finnyoun9/bluepill-ota-bootloader/CHANGELOG.md

# Changelog / 开发变更记录

> 这不是正式 release tag；项目还处于原型联调阶段。下面的 `v0.x` 是为了方便回顾而补的**开发里程碑编号**，提交 SHA 才是源码的唯一版本依据。
>
> These are development milestones, not formal release tags. The Git commit SHA remains the source of truth for every revision.

## Current status / 当前状态

- An MQTT client on the public EMQX sandbox broker (`broker.emqx.io:1883`) is implemented: it publishes the same sensor JSON as `GET /api/sensors` on a MAC-namespaced topic and accepts the same control fields as `POST /api/control` on a matching subscribe topic. **Code compiles cleanly but is not yet hardware-verified.**
- 公共 EMQX 沙盒 broker（`broker.emqx.io:1883`）的 MQTT 客户端已实现：在按 MAC 地址命名空间隔离的 topic 上发布与 `GET /api/sensors` 相同的传感器 JSON，并在对应订阅 topic 上接受与 `POST /api/control` 相同的控制字段。**代码编译通过，尚未实机验证。**
- Two active-low relay channels on PA2/PA3 and an active-low buzzer on PB1 are hardware-verified. Bluetooth supports `RELAY1/RELAY2 ON|OFF`, `RELAY`, `AUTO ON|OFF`, `MANUAL`, and `BUZZER ON|OFF`.
- PA2/PA3 两路低电平触发继电器与 PB1 低电平触发蜂鸣器均已实机验证；蓝牙命令覆盖 `RELAY1/RELAY2 ON|OFF`、`RELAY`、`AUTO ON|OFF`、`MANUAL` 和 `BUZZER ON|OFF`。
- The 15-LED WS2812B strip is hardware-verified on PB5 using a 64MHz clock-dependent GPIO bit-bang driver. The BH1750 now drives a smoothed inverse brightness curve, and frames are sent only when brightness changes.
- 15 颗 WS2812B 已在 PB5 上通过 64MHz 时钟相关的 GPIO 位操作驱动完成实机验证；BH1750 采用平滑反向亮度曲线，只有亮度变化时才发送新帧。
- The STM32 application now provides a hardware-verified local environment terminal with an SSD1306 menu, EC11 navigation, BH1750 light sensing, HC-SR501 motion sensing, and AHT20/BMP280 temperature-humidity-pressure readings.
- STM32 Application 已形成实机验证的本地环境终端：SSD1306 菜单、EC11 导航、BH1750 光照、HC-SR501 人体感应，以及 AHT20/BMP280 温湿度气压采集均已跑通。
- All four I2C devices share I2C1 on `PB6/PB7 @ 100kHz`; the split OLED/TFT application uses 17,900 B RAM (87.4%) and 33,192 B Flash (50.6%).
- 四个 I2C 设备当前共用 `PB6/PB7 @ 100kHz` 的 I2C1；双屏分工后的 Application 占用 RAM 17,900 B（87.4%）、Flash 33,192 B（50.6%）。
- Phone-driven Web OTA is hardware-verified: an iPhone connected directly to the ESP32 SoftAP, uploaded the STM32 application, and completed the update without a PC-side sender.
- 手机 Web OTA 已通过实机验证：iPhone 直连 ESP32 SoftAP、上传 STM32 Application，并在不使用电脑发包工具的情况下完成升级。
- The Web update moved the target from firmware version 1 to 2; a follow-up Bluetooth `VERSION` query returned `FW Version: 2`.
- Web 升级将目标版本从 1 更新到 2；随后通过蓝牙 `VERSION` 查询得到 `FW Version: 2`。
- The full PC → Bluetooth SPP → ESP32 SPIFFS → STM32 bootloader → Flash/CRC → application path is now hardware-verified.
- PC → 蓝牙 SPP → ESP32 SPIFFS → STM32 Bootloader → Flash/CRC → Application 的完整路径现已通过实机验证。
- A 15,956-byte application image (`CRC32 0x3B274D7E`) completed OTA successfully, and the updated STM32 application replied `FW Version: 1` after reboot.
- 15,956 字节的应用镜像（`CRC32 0x3B274D7E`）已完成 OTA；重启后 STM32 新应用返回 `FW Version: 1`。
- All three firmware targets build, the protocol smoke test passes both the classic and all-byte CRC vectors, and the current hardware wiring is stable at USART1 115200 baud.
- 三端固件均可构建；协议烟测同时覆盖经典 CRC 向量和全字节向量；当前硬件接线在 USART1 115200 baud 下稳定工作。
- The realtime Web dashboard is hardware-verified end to end: an 18-byte STM32 fixed-point snapshot, a 1-second ESP32 UART cache, and `GET /api/sensors`, with both firmware images flashed and live LAN data confirmed.
- 实时 Web 仪表盘已完成端到端实机验证：STM32 18 字节定点快照、ESP32 每秒 UART 缓存和 `GET /api/sensors` 均已烧录运行，局域网页面能持续显示真实数据。

## Milestones / 里程碑

### Unreleased — MQTT cloud publish/control / MQTT 上云发布与控制

- 中文：新增 `mqtt_client`（ESP-IDF `esp-mqtt`，通过 IDF Component Registry 引入），连接公共 EMQX 沙盒 broker `broker.emqx.io:1883`（无需账号，未加密）。Client ID 和 topic（`envlink/<mac后3字节>/sensors`、`.../control`）用 STA MAC 地址后 3 字节命名空间隔离，避免和其他设备撞车。之后若切换到私有 broker（如 EMQX Cloud Serverless 免费版），只需改 `MQTT_BROKER_URI`。
- English: Added an `esp-mqtt` client (pulled in via the ESP-IDF Component Registry) connecting to the public EMQX sandbox broker `broker.emqx.io:1883` (no account, unencrypted). The client ID and topics (`envlink/<mac-suffix>/sensors`, `.../control`) are namespaced by the last 3 bytes of the STA MAC address to avoid colliding with other clients on the shared broker. Moving to a private broker later (e.g. a free EMQX Cloud Serverless deployment) only requires changing `MQTT_BROKER_URI`.
- 中文：重构提取出 `format_sensor_json()` 和 `build_control_message()`/`send_control_message()`，HTTP 的 `/api/sensors`、`/api/control` 和 MQTT 发布/订阅现在共用同一套 JSON 序列化和 STM32 命令映射，没有重复实现。控制字段解析从手写的 `strstr` 子串扫描改为 ESP-IDF 自带的 cJSON（通过 Component Registry 引入 `espressif/cjson`）——原来的扫描依赖 if/else 顺序才能让 `"light_auto"` 不被 `"light"` 的子串匹配误判，cJSON 按精确键名查找后不再需要这个技巧。
- English: Extracted `format_sensor_json()` and `build_control_message()`/`send_control_message()` so HTTP's `/api/sensors`/`/api/control` and the MQTT publish/subscribe path share one JSON serializer and one STM32 command mapping instead of duplicating logic. Control-field parsing moved from a hand-rolled `strstr` substring scan to ESP-IDF's bundled cJSON (`espressif/cjson`, also pulled via the Component Registry) — the old scan depended on if/else ordering to keep `"light_auto"` from false-matching the `"light"` substring, which exact-key lookup no longer needs.
- 中文：`mqtt` 和 `cjson` 组件在 ESP-IDF 6.0.1 里都已从内置组件迁移到 Component Registry，不再随框架直接打包；`esp32-comm-bridge/src/idf_component.yml` 声明了这两个依赖，首次构建会自动联网拉取。
- English: Both `mqtt` and `cjson` moved from built-in ESP-IDF components to the Component Registry as of IDF 6.0.1, so they are no longer bundled with the framework by default; `esp32-comm-bridge/src/idf_component.yml` declares both dependencies, and the first build fetches them automatically.
- 验证 / Validation: ESP32 目标本机编译通过（干净 rebuild 无告警），RAM 65,312 B（19.9%），Flash 1,408,677 B（76.8%）。**MQTT 收发、topic 命名和控制回路均未接入真实硬件验证**——待 ESP32 烧录后用 MQTT 客户端订阅 sensors topic、发布 control topic 确认。 / The ESP32 target builds cleanly on this machine (clean rebuild, no warnings) at RAM 65,312 B (19.9%) and Flash 1,408,677 B (76.8%). **MQTT publish/subscribe, topic naming, and the control loop are not yet verified against real hardware** — pending an ESP32 flash and a manual MQTT client test against the sensors/control topics.

### Unreleased — Web light-strip power control / Web 灯带电源控制

- 中文：当前实物灯带接在 Relay 2 / PA3 的 `NO2`；通道定义同步改为 Relay 1 暂未使用、Relay 2 控制灯带 VCC。Web 新增语义控制字段 `{"light":true|false}`，ESP32 转换为 `RELAY2 ON|OFF` 后复用 `CMD_APP_MSG` 下发。
- English: The physical light strip is connected to Relay 2 / PA3 through NO2. Relay 1 is now unused, while the Web API maps semantic `{"light":true|false}` requests to `RELAY2 ON|OFF` over the existing `CMD_APP_MSG` path.
- 安全记录 / Safety: 雾化驱动板在未连接雾化片时直接上电后损坏；加湿器、Web 加湿器开关和 STM32 自动湿度联动均暂停，待更换模块并确认带载上电要求后再恢复。

### Unreleased — Split local UI and verified ESP32 flash / 双屏本地 UI 与 Flash 实测

- 中文：SSD1306 改为常驻四行状态屏；ST7789 改为五项卡片菜单和独立详情/控制页。EC11 旋转选择，PA1 确认；灯带页 PA1 切换 Relay 2 / NO2，新增 PA4 低电平返回键。TFT 采用状态缓存与局部刷新，不分配全屏帧缓冲。
- English: The SSD1306 is now an always-on four-line status display, while the ST7789 owns a five-card menu and dedicated detail/control pages. EC11 selects, PA1 confirms or toggles Relay 2 / NO2 on the light page, and a new active-low PA4 button returns. TFT updates are cached and partial, with no framebuffer.
- 中文：**修复 SSD1306 中文乱码**——根因是 SSD1306 页寻址按"每字节=8 个垂直像素（COM 列）"存储，而 TFT 共用的中文字模是逐行水平扫描（每行 2 字节）存的，直接搬字节会把行列写乱。`oled.c` 新增 `oled_show_utf8()` 做 3 字节 UTF-8 解码，再由 `oled_show_chinese()` 对字模做位转置（水平扫描 → 垂直分页格式）后写入，与 `oled_show_char()` 的 ASCII 路径共用同一套分页写入逻辑。修复前的实拍对比见 [docs/photos/](photos/)。
- English: **Fixed garbled Chinese text on the SSD1306.** Root cause: the SSD1306's page-addressing mode stores each byte as 8 vertical pixels (one COM column), while the Chinese glyph table shared with the TFT is stored as horizontal row-scan data (2 bytes per row) — writing it directly scrambled rows and columns. `oled.c` gained `oled_show_utf8()` for 3-byte UTF-8 decoding and `oled_show_chinese()` to transpose each glyph (horizontal scan → vertical page format) before writing, sharing the same page-write path as the ASCII `oled_show_char()`. Before/after photos are in [docs/photos/](photos/).
- 验证 / Validation: `esptool flash_id` identified JEDEC `c4:6016` as 4MB. The ESP32 config now uses 4MB with a 1.75MB factory partition and 2.19MB SPIFFS storage. Both targets build; STM32 uses 17,900 B RAM / 33,192 B Flash, ESP32 uses 65,184 B RAM / 1,372,089 B app Flash. Hardware UI validation is pending flashing and button wiring.

### Unreleased — Actuator and WS2812B hardware closure / 执行器与灯带实机闭环

- 中文：继电器从与 TFT 冲突的 PB12/PB13 改到 PA2/PA3，有源蜂鸣器使用 PB1；三路均为低电平触发，默认上电关闭。两路继电器触点、共地、蓝牙手动命令和蜂鸣器均已实机验证。
- English: Moved the relays from TFT-conflicting PB12/PB13 to PA2/PA3 and placed the active buzzer on PB1. All three outputs are active-low and default off; relay contacts, common ground, Bluetooth manual commands, and buzzer operation are hardware-verified.
- 中文：WS2812B 的 SPI1 4MHz/5-bit 编码在 DIN 上看起来满足时序，但第一颗灯珠 DOUT 没有转发。切换到 PB5 GPIO bit-bang 后，DOUT 捕获到后 14 颗的 336 bit / 42 字节有效帧。最终保留 bit-bang，并将 BH1750 的 5~1000 lux 反向映射到亮度 160~1，每 200ms 计算、每次平滑变化 16 级、2 级死区抑制抖动、仅变化时发帧。
- English: The SPI1 4MHz/5-bit waveform looked valid at DIN, but the first LED produced no DOUT. After switching to PB5 GPIO bit-banging, DOUT carried a valid 336-bit / 42-byte frame for the remaining 14 LEDs. The final driver keeps bit-banging and maps BH1750's 5..1000 lux range inversely to brightness 160..1, evaluated every 200ms with a 16-level step, a 2-level deadband, and change-only transmission.
- 验证 / Validation: Application builds without warnings at RAM 17,780 B (86.8%) and Flash 30,892 B (47.1%). Logic-analyzer evidence is retained under `docs/captures/`. / Application builds without warnings at RAM 17,780 B (86.8%) and Flash 30,892 B (47.1%); logic-analyzer evidence is retained under `docs/captures/`.

### Unreleased — Realtime Web sensor dashboard / Web 实时传感器仪表盘

- 中文：新增 `CMD_GET_SENSOR_SNAPSHOT (0x32)` / `CMD_SENSOR_SNAPSHOT_RSP (0x87)` 和 18B 定点快照。STM32 在现有 `vAppTask` 内发布状态，没有新增任务或浮点格式化。
- English: Added `CMD_GET_SENSOR_SNAPSHOT (0x32)` / `CMD_SENSOR_SNAPSHOT_RSP (0x87)` and an 18-byte fixed-point snapshot. STM32 publishes it from the existing `vAppTask`, without another task or floating-point formatting.
- 中文：ESP32 每秒查询并缓存快照，新增 `GET /api/sensors`；Web 首页按秒刷新真实传感器和执行器状态，缓存超过 5 秒即显示数据超时。OTA、蓝牙命令与轮询共享 UART 事务锁。
- English: The ESP32 polls and caches the snapshot once per second and exposes `GET /api/sensors`. The Web home page refreshes real sensor and actuator state every second and reports a timeout after 5 seconds; OTA, Bluetooth commands, and polling share one UART transaction lock.
- 验证 / Validation: protocol smoke test and both firmware builds pass. Application: RAM 17,796 B (86.9%), Flash 31,264 B (47.7%). ESP32: RAM 65,184 B (19.9%), Flash 1,372,089 B (74.8%). Both images were flashed and verified; passive Web/API checks confirmed the new light/NO2 UI with both relays and AUTO remaining off. / 协议烟测、两端构建和烧录校验通过；被动 Web/API 检查确认新版灯带/NO2 页面，两路继电器与 AUTO 均保持关闭。

### v0.13 — Two-channel relay control / 两路继电器控制

**Commit:** [`9edc875`](https://github.com/finnyoun9/bluepill-ota-bootloader/commit/9edc875)

- 中文：新增 `relay` 驱动（PB12/PB13，低电平触发，默认手动模式），并在 OLED 系统页显示两路状态与自动模式；ESP32 侧新增 `RELAY1/RELAY2 ON|OFF`、`RELAY`、`AUTO ON|OFF`、`MANUAL` 蓝牙命令，经 `CMD_APP_MSG` 转发、`CMD_STATUS_RSP` 回读状态，与 Web OTA 共用互斥锁。
- English: Added a `relay` driver (PB12/PB13, active-low, manual by default) and relay/auto-mode display on the OLED system page. The ESP32 bridge gained `RELAY1/RELAY2 ON|OFF`, `RELAY`, `AUTO ON|OFF`, and `MANUAL` Bluetooth commands, forwarded as `CMD_APP_MSG` with a `CMD_STATUS_RSP` status reply, sharing the OTA mutex.
- 中文：自动联动以继电器1为加湿器：AHT20 湿度 <40% 开启、≥45% 关闭（5% 回差防抖），复用 vAppTask 现有 2 秒采样周期，未新增任务。
- English: In AUTO mode, relay 1 drives the humidifier: AHT20 humidity below 40% turns it on, 45% or above turns it off (5% hysteresis), reusing the existing 2-second sampling period in vAppTask without adding a task.
- 注 / Note: 这是当时 PB12/PB13 引脚方案下的通道定义。当前实物接线已调整为 **Relay 1 / PA2 暂未使用、Relay 2 / PA3 / NO2 = 灯带 VCC**；加湿器和自动湿度联动暂停。
- 验证 / Validation: ESP32 侧编译通过（RAM 19.9%、Flash 73.6%）。**STM32 侧与继电器实机联动尚未验证**——待 Windows 上 `pio run -e app` 编译烧录后用蓝牙命令与 OLED 系统页确认。 / The ESP32 target compiles (RAM 19.9%, Flash 73.6%). **The STM32 side and hardware relay action are not yet verified** — pending a Windows `pio run -e app` build/flash and confirmation via Bluetooth commands and the OLED system page.

### v0.12 — Local environment terminal / STM32 本地环境终端

**Commit:** [`ed8a9b9`](https://github.com/finnyoun9/bluepill-ota-bootloader/commit/ed8a9b9)

- 中文：新增 I2C1 HAL 总线层，并在 `PB6/PB7 @ 100kHz` 上接入 SSD1306、BH1750 与 AHT20+BMP280 组合板；AHT20 数据带 CRC-8 检查，BMP280 使用工厂校准参数和 Bosch 定点补偿算法。
- English: Added a HAL-based I2C1 bus layer and integrated SSD1306, BH1750, and an AHT20+BMP280 combo board on `PB6/PB7 @ 100kHz`. AHT20 reads are CRC-8 checked, while BMP280 uses factory calibration and Bosch fixed-point compensation.
- 中文：新增五页 OLED 菜单。EC11 的 A/B 相使用双边沿 EXTI 与完整 Gray-code 状态表，每个完整卡点输出一次上下事件；PA1 独立按键负责确认和返回。
- English: Added a five-page OLED menu. The EC11 A/B phases use dual-edge EXTI and a full Gray-code transition table, publishing one navigation event per detent; a separate PA1 button handles confirm/back actions.
- 中文：新增 HC-SR501 的 30 秒预热提示和状态页；环境页显示温度、`% RH` 湿度与 hPa 气压，全部使用整数/定点运算。
- English: Added an HC-SR501 status page with a 30-second warm-up state. The environment page shows temperature, relative humidity in `% RH`, and pressure in hPa using integer/fixed-point math only.
- 验证 / Validation: OLED、旋钮、确认键、BH1750、HC-SR501、AHT20 和 BMP280 均通过面包板实机验证。三目标构建和协议烟测通过；Application 使用 RAM 17,676 B（86.3%）和 Flash 25,200 B（38.5%）。 / OLED, encoder, confirm button, BH1750, HC-SR501, AHT20, and BMP280 were all verified on the breadboard. All three firmware targets and the protocol smoke test pass; the application uses 17,676 B RAM and 25,200 B Flash.

### v0.11 — Phone-driven Web OTA / 手机独立完成 Web OTA

**Commit:** [`5b6ab60`](https://github.com/finnyoun9/bluepill-ota-bootloader/commit/5b6ab60)

- 中文：ESP32 新增常驻 SoftAP `STM32-OTA-Bridge` 和响应式 OTA 页面，iPhone 连接热点后访问 `192.168.4.1` 即可选择 Application `.bin`、填写版本并查看上传/写入状态。
- English: Added an always-available `STM32-OTA-Bridge` SoftAP and a responsive OTA page. An iPhone can connect to `192.168.4.1`, choose an application image, set its version, and follow upload/programming status.
- 中文：新增 `GET /api/status`、`POST /api/upload`、`POST /api/start`；上传过程流式写入 SPIFFS，不把完整固件放进 RAM。OTA 任务与蓝牙路径共用互斥锁，避免两个入口同时操作 STM32。
- English: Added `GET /api/status`, `POST /api/upload`, and `POST /api/start`. Uploads stream into SPIFFS instead of buffering a full image in RAM, while a shared mutex prevents concurrent Web/Bluetooth transfers.
- 中文：除大小和 CRC 外，ESP32 还检查 Cortex-M 初始栈、Thumb Reset Vector 和 `0x08002000..0x0800F800` Application 地址范围，防止误传 Bootloader 或无关固件。
- English: Beyond size and CRC checks, the bridge validates the Cortex-M stack pointer, Thumb reset vector, and the `0x08002000..0x0800F800` application range to reject bootloader or unrelated binaries.
- 验证 / Validation: iPhone 上传 15,956-byte `fw_v2.bin` 后页面完成 OTA；COM6 查询返回 `FW Version: 2`。ESP32 构建占用 RAM 65,152 B（19.9%）、Flash 1,349,653 B（73.6%）。 / The iPhone-uploaded 15,956-byte image completed OTA, and COM6 reported firmware version 2.

### v0.10 — Hardware-verified end-to-end OTA / 实机验证完整 OTA 闭环

**Commit:** [`646bda2`](https://github.com/finnyoun9/bluepill-ota-bootloader/commit/646bda2)

- 中文：把 PC→ESP32 暂存改成文本安全的 Base64 分块协议：`FW` 声明元数据，`DATA <offset>,<base64>` 逐块发送并等待偏移量 ACK，`VERIFY` 做暂存前检，最后 `SEND` 触发 STM32 OTA。丢 ACK 时允许同一块安全重试，SPIFFS 文件保持单次打开，减少重复打开/追加带来的不确定性。
- English: Reworked PC-to-ESP32 staging into a text-safe Base64 block protocol: `FW` declares metadata, `DATA <offset>,<base64>` sends acknowledged blocks, `VERIFY` performs the staging preflight, and `SEND` starts STM32 OTA. Lost ACKs can be retried safely, and SPIFFS remains open for the entire staging write.
- 中文：定位并修正 `shared/protocol.c` 与 ESP32 镜像里 4 个错误的 CRC-32 查表常量。经典 `123456789` 测试会漏掉该错误，因此新增 `0x00..0xFF` 全字节回归向量，期望值为 `0x29058C73`。
- English: Corrected four bad CRC-32 table constants in both protocol implementations. The classic `123456789` vector did not exercise those entries, so an `0x00..0xFF` regression vector with expected CRC `0x29058C73` was added.
- 验证 / Validation: 15,956-byte app image, CRC `0x3B274D7E`; ESP32 reported `STATUS: OTA complete!`; after reboot, `VERSION` returned `FW Version: 1`. / A 15,956-byte image with CRC `0x3B274D7E` completed OTA, and the rebooted STM32 reported firmware version 1.

### v0.9 — Deterministic full-OTA pipeline / 可确定时序的完整 OTA 链路

**Commit:** [`1898386`](https://github.com/finnyoun9/bluepill-ota-bootloader/commit/1898386f95054f242bc59570a229fa337a0dc316)

- 中文：修掉了几处会让真实 OTA 必然失败的代码问题：应用先写 OTA 配置并回复 `CMD_OTA_READY`，ESP32 再等待 Bootloader；1 KB 数据块连同 4 字节序号的 1028 字节负载被正式支持；9600 baud 下 ACK 超时改为 2 秒；Bootloader 不再在 `OTA_BEGIN` 时多擦一遍整个 App 区。
- English: Fixed several defects that would make real OTA fail: the application now persists the OTA request and replies with `CMD_OTA_READY` before the ESP32 waits for the bootloader; the protocol now accepts a 1028-byte OTA payload (4-byte sequence + 1 KB data); the 9600-baud ACK timeout is 2 s; and the bootloader no longer redundantly erases the entire app region at `OTA_BEGIN`.
- 中文：把 CRC 统一为标准 IEEE CRC-32，强制 Flash 擦写函数保留在 `.ramfunc` 并在启动时复制到 RAM；新增 `tools/bridge_ota.py` 自动走 Bluetooth COM → SPIFFS → STM32 的流程，以及 C 协议烟测。
- English: Standardized CRC handling on IEEE CRC-32, forced Flash-writing functions to remain in `.ramfunc` and copied them to RAM at startup, added `tools/bridge_ota.py` for Bluetooth COM → SPIFFS → STM32 transfer, and added a C protocol smoke test.
- 验证 / Validation: 三个 PlatformIO 目标已构建成功、协议烟测通过、新 STM32 Bootloader/App 已由 ST-Link 写入并 Verify；ESP32 刷写和完整 OTA 实机闭环仍待进行。 / All three PlatformIO targets build, the protocol smoke test passes, and the new STM32 bootloader/app were ST-Link programmed and verified; ESP32 flashing and full OTA hardware closure are still pending.

### v0.1 — Initial OTA system skeleton / 初始 OTA 系统骨架

**Commit:** [`6e1872e`](https://github.com/finnyoun9/bluepill-ota-bootloader/commit/6e1872e0634f72b148a94253b15cd8ad6c401eda)

- 中文：建立 STM32 Bootloader、FreeRTOS 应用、ESP32 网关、共享 UART 帧协议和 Python 发包工具的第一版工程骨架；定义了 Flash 分区、OTA 配置页和基本状态机。
- English: Created the first project skeleton: STM32 bootloader, FreeRTOS application, ESP32 gateway, shared UART framing protocol, and a Python sender. It also defined the Flash layout, OTA config page, and basic state machines.
- 验证边界 / Validation boundary: 架构和代码基线，不代表当时已完成硬件联调。 / Architectural baseline only; no end-to-end hardware claim.

### v0.2 — Project documentation and target architecture / 项目文档与目标架构

**Commit:** [`de46d69`](https://github.com/finnyoun9/bluepill-ota-bootloader/commit/de46d694931b2bfdd0d10ce80ee904d756e2ed29)

- 中文：补充完整项目框架、传感器/执行器扩展架构和 README，使项目的“最终目标形态”可读。
- English: Added the broader project framework, planned sensor/actuator architecture, and a richer README so the intended end state is documented.
- 注意 / Note: 这里包含设计目标，不能一律理解为已经接上硬件实现。 / Some items describe intended architecture, not already-integrated hardware.

### v0.3 — STM32 build-layout corrections / STM32 构建与布局修正

**Commit:** [`c7a211d`](https://github.com/finnyoun9/bluepill-ota-bootloader/commit/c7a211d0de722e9045e7aa0510f536f7bfe98607)

- 中文：修正 `BootConfig_t` 尺寸断言和 Flash 宏保护，并补上根目录 PlatformIO 配置，避免 STM32 编译和布局定义互相冲突。
- English: Fixed the `BootConfig_t` size assertion and Flash macro guards, and added the root PlatformIO configuration to prevent STM32 build/layout conflicts.

### v0.4 — Buildable FreeRTOS application / 可构建的 FreeRTOS 应用

**Commit:** [`5afecf0`](https://github.com/finnyoun9/bluepill-ota-bootloader/commit/5afecf01033f823a14e3dda4f878ed2cdbbbfb4f)

- 中文：把 FreeRTOS 内核和 PlatformIO 构建接起来，修正应用链接脚本与启动配置，应用固件第一次能作为独立目标构建。
- English: Integrated the FreeRTOS kernel with PlatformIO and corrected application linker/startup settings so the application could build as a standalone target.

### v0.5 — Usable ESP32 staging bridge / 可用的 ESP32 暂存网关

**Commit:** [`3cd7d6a`](https://github.com/finnyoun9/bluepill-ota-bootloader/commit/3cd7d6a5a40edf7abe8ddf903dcade387ce48e27)

- 中文：增加 SPIFFS 分区和蓝牙固件暂存流程；支持 `FW <version>,<crc>`、二进制文件推送、`SEND`、Wi-Fi 凭据保存及 `OTA <url>` 下载入口。
- English: Added a SPIFFS partition and Bluetooth firmware staging flow; introduced `FW <version>,<crc>`, binary file push, `SEND`, persistent Wi-Fi credentials, and the `OTA <url>` download entry point.
- 验证边界 / Validation boundary: 功能接口已具备，但当时还没有证明真实 STM32 Flash OTA 已跑通。 / The interface existed, but real STM32 Flash OTA was not yet proven.

### v0.5.1 — ESP-IDF source inclusion / ESP-IDF 源文件接入

**Commit:** [`60308cd`](https://github.com/finnyoun9/bluepill-ota-bootloader/commit/60308cda608a3fb43fffa8f623888d715e475b09)

- 中文：补齐 ESP-IDF/PlatformIO 的组件与源文件配置，使 ESP32 目标能正确带入共享协议实现。
- English: Added ESP-IDF/PlatformIO component and source configuration so the ESP32 target includes the shared protocol implementation correctly.

### v0.5.2 — Reproducible ESP-IDF configuration snapshot / 可复现的 ESP-IDF 配置快照

**Commit:** [`9fff0b8`](https://github.com/finnyoun9/bluepill-ota-bootloader/commit/9fff0b84942eb0b94bad1647e17edaa68dae7a81)

- 中文：提交由 ESP-IDF 生成的 `sdkconfig` 快照，固定当前开发板所需的蓝牙/构建配置。
- English: Committed the generated `sdkconfig` snapshot to preserve the Bluetooth and build configuration needed by the development board.

### v0.5.3 — ESP-IDF 6 Bluetooth API compatibility / ESP-IDF 6 蓝牙 API 兼容

**Commit:** [`34d24ce`](https://github.com/finnyoun9/bluepill-ota-bootloader/commit/34d24cec4a161f812431122b4085951ab2143892)

- 中文：适配 ESP-IDF 6 的 Classic Bluetooth/SPP 初始化 API，修复 UART 配置写法和 Wi-Fi 状态读取，使蓝牙服务真正可以启动。
- English: Adapted the bridge to ESP-IDF 6 Classic Bluetooth/SPP initialization APIs, corrected UART setup, and fixed Wi-Fi status handling so the Bluetooth service could actually start.

### v0.6 — ESP32 build green under the former 2 MB assumption / 按当时 2 MB 假设构建通过

**Commit:** [`abd9953`](https://github.com/finnyoun9/bluepill-ota-bootloader/commit/abd9953f41635c0dcc5aacff9e974efd887c87da)

- 中文：当时按 2 MB 假设调整分区；修复 ESP-IDF 6 构建问题，并为 ESP32 复制共享协议实现，三个目标开始能稳定编译。2026-08-12 后续用 `esptool flash_id` 证实实物为 4 MB，因此 2 MB 属于历史误判。
- English: Adjusted partitions under the then-current 2 MB assumption, fixed ESP-IDF 6 build issues, and mirrored the shared protocol for ESP32. A later `esptool flash_id` check on 2026-08-12 proved the hardware is 4 MB, so the 2 MB statement was a historical misidentification.

### v0.7 — Three-target build evidence / 三目标构建证据

**Commit:** [`f725239`](https://github.com/finnyoun9/bluepill-ota-bootloader/commit/f725239bea23fe606b883361214280aa9945e9d8)

- 中文：记录 Bootloader、STM32 应用、ESP32 Bridge 三个固件目标的构建结果、内存占用和已知风险。
- English: Recorded build results, memory usage, and known risks for the bootloader, STM32 application, and ESP32 bridge targets.

### v0.8 — Bluetooth-to-STM32 hardware bring-up / 蓝牙到 STM32 实机联调

**Commit:** [`860fc96`](https://github.com/finnyoun9/bluepill-ota-bootloader/commit/860fc96209a5a0f4053c98471b5677660212a2d2)

- 中文：这是当时实际硬件排障的核心提交。它先把 STM32 链路统一到 `USART1 PA9/PA10 @ 9600`，增加兼容当前 ST-Link/OpenOCD 的烧录脚本，并修复 ESP32 Classic SPP 配置、蓝牙文本命令分包重组和 UART 协议镜像问题；后续当前版本已提升到 115200 baud。
- English: This was the key hardware bring-up commit. It first standardized the STM32 link on `USART1 PA9/PA10 @ 9600`, added a ST-Link/OpenOCD-compatible uploader, and fixed ESP32 Classic SPP configuration, split text-command reassembly, and the UART protocol mirror; the current revision later moved to 115200 baud.
- 实机结果 / Hardware evidence: PC Bluetooth `COM6` 连续 10 次 `VERSION` 均得到 `FW Version: 0`；逻辑分析仪也解码到了从 ESP32 发往 `PA10` 的有效帧。
- Remaining scope / 尚未覆盖: 这只证明控制链路能双向收发，**不等于**固件经蓝牙 OTA 到 STM32 已经完成。

## How to use this file / 如何使用这份记录

- 想看源码差异：点击上面的 SHA，或执行 `git show <sha>`。
- To inspect the code-level diff, open the SHA above or run `git show <sha>`.
- 想看当前可执行步骤：优先看 `README.md` 和 `docs/build-notes.md`；这里专门回答“某一版为什么改、改到了哪”。
- For current runnable steps, start with `README.md` and `docs/build-notes.md`; this file answers why a revision changed and what it actually reached.
