finnyoun9/bluepill-ota-bootloader/application/Core/Src/tft_chinese_font.c

#include "tft_chinese_font.h"

#include <stddef.h>

typedef struct {
    uint16_t codepoint;
    uint8_t rows[TFT_CHINESE_GLYPH_HEIGHT * 2U];
} ChineseGlyph_t;

/* Microsoft YaHei UI rendered at 16 px and reduced to the characters used by
 * the local menu. A subset keeps the F103 application footprint predictable. */
static const ChineseGlyph_t g_chinese_glyphs[] = {
    {0x73AFU,{0x00U,0x00U,0x7DU,0xFEU,0x10U,0x20U,0x10U,0x20U,0x10U,0x60U,0x7CU,0x40U,0x10U,0xE8U,0x10U,0xA4U,0x11U,0xA6U,0x13U,0x22U,0x1EU,0x21U,0x64U,0x20U,0x00U,0x20U,0x00U,0x20U,0x00U,0x00U,0x00U,0x00U}}, /* 环 */
    {0x5883U,{0x00U,0x00U,0x10U,0x30U,0x13U,0xFEU,0x10U,0xC4U,0x7FU,0xFFU,0x10U,0x00U,0x11U,0xFEU,0x11U,0x02U,0x11U,0xFEU,0x11U,0x02U,0x1DU,0xFEU,0x60U,0x51U,0x00U,0x91U,0x07U,0x1EU,0x00U,0x00U,0x00U,0x00U}}, /* 境 */
    {0x706FU,{0x00U,0x00U,0x11U,0xFEU,0x10U,0x10U,0x52U,0x10U,0x52U,0x10U,0x34U,0x10U,0x34U,0x10U,0x10U,0x10U,0x18U,0x10U,0x1CU,0x10U,0x24U,0x10U,0x22U,0x10U,0x60U,0x10U,0x41U,0xF0U,0x00U,0x00U,0x00U,0x00U}}, /* 灯 */
    {0x5149U,{0x00U,0x00U,0x00U,0x80U,0x20U,0x82U,0x10U,0x84U,0x08U,0x88U,0x04U,0x90U,0x00U,0x80U,0x7FU,0xFFU,0x04U,0x20U,0x04U,0x20U,0x04U,0x21U,0x08U,0x21U,0x10U,0x21U,0x60U,0x3EU,0x00U,0x00U,0x00U,0x00U}}, /* 光 */
    {0x4EBAU,{0x00U,0x00U,0x00U,0x80U,0x00U,0x80U,0x00U,0x80U,0x00U,0x80U,0x01U,0x80U,0x01U,0x40U,0x01U,0x40U,0x02U,0x20U,0x06U,0x20U,0x04U,0x10U,0x08U,0x08U,0x30U,0x06U,0x60U,0x03U,0x00U,0x00U,0x00U,0x00U}}, /* 人 */
    {0x4F53U,{0x00U,0x00U,0x08U,0x20U,0x18U,0x20U,0x17U,0xFFU,0x10U,0x70U,0x30U,0xB0U,0x70U,0xA8U,0x51U,0xA8U,0x11U,0x24U,0x12U,0xFEU,0x14U,0x23U,0x18U,0x21U,0x10U,0x20U,0x10U,0x20U,0x00U,0x00U,0x00U,0x00U}}, /* 体 */
    {0x7CFBU,{0x00U,0x00U,0x00U,0x1EU,0x3FU,0xE0U,0x03U,0x00U,0x0CU,0x0CU,0x3FU,0xF8U,0x00U,0xE0U,0x03U,0x10U,0x0CU,0x0CU,0x3FU,0xFEU,0x00U,0x81U,0x0CU,0x98U,0x18U,0x8EU,0x63U,0x83U,0x00U,0x00U,0x00U,0x00U}}, /* 系 */
    {0x7EDFU,{0x00U,0x00U,0x08U,0x20U,0x10U,0x10U,0x13U,0xFFU,0x20U,0x60U,0x4CU,0xC8U,0x79U,0x04U,0x23U,0xFEU,0x3CU,0x91U,0x60U,0x90U,0x0CU,0x91U,0x31U,0x11U,0x42U,0x11U,0x0CU,0x1EU,0x00U,0x00U,0x00U,0x00U}}, /* 统 */
    {0x5173U,{0x00U,0x00U,0x08U,0x08U,0x06U,0x10U,0x02U,0x20U,0x3FU,0xFEU,0x00U,0x80U,0x00U,0x80U,0x00U,0x80U,0x7FU,0xFFU,0x01U,0x80U,0x03U,0x40U,0x06U,0x20U,0x1CU,0x18U,0x60U,0x07U,0x00U,0x00U,0x00U,0x00U}}, /* 关 */
    {0x4E8EU,{0x00U,0x00U,0x3FU,0xFEU,0x00U,0x80U,0x00U,0x80U,0x00U,0x80U,0x00U,0x80U,0x7FU,0xFFU,0x00U,0x80U,0x00U,0x80U,0x00U,0x80U,0x00U,0x80U,0x00U,0x80U,0x00U,0x80U,0x07U,0x80U,0x00U,0x00U,0x00U,0x00U}}, /* 于 */
    {0x5F00U,{0x00U,0x00U,0x3FU,0xFEU,0x04U,0x10U,0x04U,0x10U,0x04U,0x10U,0x04U,0x10U,0x7FU,0xFFU,0x04U,0x10U,0x04U,0x10U,0x04U,0x10U,0x08U,0x10U,0x08U,0x10U,0x30U,0x10U,0x60U,0x10U,0x00U,0x00U,0x00U,0x00U}}, /* 开 */
    {0x6A21U,{0x00U,0x00U,0x10U,0x88U,0x13U,0xFFU,0x10U,0x88U,0x7DU,0xFEU,0x11U,0x02U,0x39U,0xFEU,0x35U,0x02U,0x51U,0xFEU,0x50U,0x20U,0x13U,0xFFU,0x10U,0x70U,0x10U,0xC8U,0x17U,0x07U,0x00U,0x00U,0x00U,0x00U}}, /* 模 */
    {0x5F0FU,{0x00U,0x00U,0x00U,0x28U,0x00U,0x24U,0x00U,0x24U,0x7FU,0xFFU,0x00U,0x20U,0x00U,0x20U,0x3FU,0xA0U,0x04U,0x20U,0x04U,0x10U,0x04U,0x11U,0x04U,0x19U,0x07U,0xCFU,0x78U,0x06U,0x00U,0x00U,0x00U,0x00U}}, /* 式 */
    {0x4EAEU,{0x00U,0x00U,0x00U,0xC0U,0x3FU,0xFFU,0x00U,0x00U,0x0FU,0xF8U,0x08U,0x08U,0x0FU,0xF8U,0x00U,0x00U,0x3FU,0xFEU,0x20U,0x02U,0x07U,0xF0U,0x04U,0x11U,0x0CU,0x11U,0x30U,0x1EU,0x00U,0x00U,0x00U,0x00U}}, /* 亮 */
    {0x5EA6U,{0x00U,0x00U,0x00U,0xC0U,0x1FU,0xFFU,0x10U,0x00U,0x11U,0x08U,0x1FU,0xFFU,0x11U,0x08U,0x11U,0xF8U,0x10U,0x00U,0x17U,0xFCU,0x12U,0x08U,0x21U,0xB0U,0x21U,0xF0U,0x4EU,0x0FU,0x00U,0x00U,0x00U,0x00U}}, /* 度 */
    {0x8BEDU,{0x00U,0x00U,0x23U,0xFEU,0x10U,0x80U,0x08U,0x80U,0x03U,0xFCU,0x70U,0x84U,0x10U,0x84U,0x17U,0xFEU,0x10U,0x00U,0x11U,0xFCU,0x11U,0x04U,0x15U,0x04U,0x19U,0xFCU,0x21U,0x04U,0x00U,0x00U,0x00U,0x00U}}, /* 语 */
    {0x8A00U,{0x01U,0x00U,0x00U,0x80U,0x7FU,0xFFU,0x00U,0x00U,0x3FU,0xFEU,0x00U,0x00U,0x1FU,0xFCU,0x00U,0x00U,0x1FU,0xFCU,0x10U,0x04U,0x10U,0x04U,0x10U,0x04U,0x1FU,0xFCU,0x10U,0x04U,0x00U,0x00U,0x00U,0x00U}}, /* 言 */
    {0x4E2DU,{0x00U,0x00U,0x00U,0x80U,0x00U,0x80U,0x00U,0x80U,0x3FU,0xFEU,0x20U,0x82U,0x20U,0x82U,0x20U,0x82U,0x3FU,0xFEU,0x20U,0x82U,0x00U,0x80U,0x00U,0x80U,0x00U,0x80U,0x00U,0x80U,0x00U,0x00U,0x00U,0x00U}}, /* 中 */
    {0x6587U,{0x00U,0x00U,0x01U,0x80U,0x00U,0x40U,0x7FU,0xFFU,0x08U,0x08U,0x08U,0x08U,0x04U,0x10U,0x04U,0x10U,0x02U,0x20U,0x01U,0x40U,0x01U,0x80U,0x03U,0x60U,0x1CU,0x1CU,0x60U,0x07U,0x00U,0x00U,0x00U,0x00U}}, /* 文 */
    {0x6E29U,{0x00U,0x00U,0x31U,0xFCU,0x19U,0x04U,0x0DU,0xFCU,0x21U,0x04U,0x31U,0xFCU,0x11U,0x04U,0x00U,0x00U,0x13U,0xFEU,0x12U,0x52U,0x12U,0x52U,0x22U,0x52U,0x22U,0x52U,0x2FU,0xFFU,0x00U,0x00U,0x00U,0x00U}}, /* 温 */
    {0x6E7FU,{0x00U,0x00U,0x21U,0xFEU,0x11U,0x02U,0x09U,0xFEU,0x21U,0x02U,0x11U,0xFEU,0x09U,0x02U,0x00U,0x48U,0x12U,0x49U,0x12U,0x4AU,0x11U,0x4AU,0x21U,0x4CU,0x20U,0x48U,0x27U,0xFFU,0x00U,0x00U,0x00U,0x00U}}, /* 湿 */
    {0x6C14U,{0x00U,0x00U,0x04U,0x00U,0x0CU,0x00U,0x0FU,0xFEU,0x08U,0x00U,0x17U,0xFCU,0x30U,0x00U,0x2FU,0xF8U,0x00U,0x08U,0x00U,0x08U,0x00U,0x09U,0x00U,0x09U,0x00U,0x05U,0x00U,0x06U,0x00U,0x00U,0x00U,0x00U}}, /* 气 */
    {0x538BU,{0x00U,0x00U,0x1FU,0xFFU,0x10U,0x00U,0x10U,0x20U,0x10U,0x20U,0x10U,0x20U,0x17U,0xFEU,0x10U,0x20U,0x10U,0x28U,0x10U,0x24U,0x10U,0x26U,0x20U,0x22U,0x20U,0x20U,0x4FU,0xFFU,0x00U,0x00U,0x00U,0x00U}}, /* 压 */
    {0x72B6U,{0x00U,0x00U,0x04U,0x28U,0x04U,0x24U,0x24U,0x22U,0x24U,0x20U,0x15U,0xFEU,0x14U,0x20U,0x04U,0x20U,0x0CU,0x50U,0x14U,0x50U,0x24U,0x58U,0x04U,0x88U,0x05U,0x04U,0x06U,0x02U,0x00U,0x00U,0x00U,0x00U}}, /* 状 */
    {0x6001U,{0x00U,0x00U,0x00U,0x80U,0x00U,0x80U,0x7FU,0xFEU,0x01U,0x80U,0x02U,0x40U,0x06U,0x30U,0x19U,0x0CU,0x60U,0x83U,0x00U,0x00U,0x11U,0x84U,0x24U,0xD2U,0x44U,0x11U,0x07U,0xE0U,0x00U,0x00U,0x00U,0x00U}}, /* 态 */
    {0x68C0U,{0x00U,0x00U,0x10U,0x20U,0x10U,0x70U,0x10U,0x50U,0x7CU,0x88U,0x11U,0x04U,0x33U,0xFAU,0x38U,0x00U,0x34U,0x44U,0x52U,0x48U,0x53U,0x28U,0x11U,0x28U,0x10U,0x10U,0x17U,0xFEU,0x00U,0x00U,0x00U,0x00U}}, /* 检 */
    {0x6D4BU,{0x00U,0x00U,0x27U,0xE2U,0x14U,0x2AU,0x0DU,0x2AU,0x25U,0x2AU,0x35U,0x2AU,0x15U,0x2AU,0x05U,0x2AU,0x15U,0x2AU,0x15U,0x2AU,0x13U,0x0AU,0x22U,0xC2U,0x24U,0x62U,0x28U,0x1EU,0x00U,0x00U,0x00U,0x00U}}, /* 测 */
    {0x65E0U,{0x00U,0x00U,0x3FU,0xFEU,0x00U,0x80U,0x00U,0x80U,0x00U,0x80U,0x01U,0x00U,0x7FU,0xFFU,0x01U,0x00U,0x02U,0x40U,0x02U,0x40U,0x04U,0x41U,0x08U,0x41U,0x30U,0x41U,0x60U,0x7EU,0x00U,0x00U,0x00U,0x00U}}, /* 无 */
    {0x9884U,{0x00U,0x00U,0x7DU,0xFFU,0x0CU,0x20U,0x28U,0x20U,0x18U,0xFEU,0x18U,0x82U,0x7EU,0x92U,0x12U,0x92U,0x14U,0x92U,0x10U,0x92U,0x10U,0xB2U,0x10U,0x78U,0x10U,0xC6U,0x73U,0x03U,0x00U,0x00U,0x00U,0x00U}}, /* 预 */
    {0x70EDU,{0x00U,0x00U,0x08U,0x40U,0x08U,0x40U,0x3FU,0xFCU,0x08U,0x44U,0x0FU,0xC4U,0x38U,0xE4U,0x08U,0xB5U,0x09U,0x85U,0x3BU,0x03U,0x00U,0x00U,0x12U,0x24U,0x33U,0x32U,0x21U,0x11U,0x00U,0x00U,0x00U,0x00U}}, /* 热 */
    {0x6545U,{0x00U,0x00U,0x08U,0x20U,0x08U,0x20U,0x7FU,0xFEU,0x08U,0x44U,0x08U,0xC4U,0x08U,0x44U,0x3FU,0x28U,0x21U,0x28U,0x21U,0x38U,0x21U,0x30U,0x21U,0x38U,0x3FU,0x4CU,0x20U,0x86U,0x00U,0x00U,0x00U,0x00U}}, /* 故 */
    {0x969CU,{0x00U,0x00U,0x3CU,0x30U,0x27U,0xFFU,0x24U,0xC4U,0x2BU,0xFFU,0x28U,0x00U,0x29U,0xFEU,0x25U,0x02U,0x25U,0xFEU,0x25U,0x02U,0x25U,0xFEU,0x3CU,0x10U,0x23U,0xFFU,0x20U,0x10U,0x00U,0x00U,0x00U,0x00U}}, /* 障 */
    {0x65CBU,{0x00U,0x00U,0x10U,0x80U,0x10U,0x80U,0x11U,0xFFU,0xFDU,0x00U,0x23U,0x00U,0x23U,0xFEU,0x3CU,0x32U,0x24U,0x32U,0x25U,0x30U,0x25U,0x3EU,0x6DU,0x30U,0x4DU,0xB0U,0x4BU,0xF0U,0xBAU,0x3FU,0x00U,0x00U}}, /* 旋 */
    {0x8F6CU,{0x10U,0x20U,0x10U,0x20U,0x10U,0x20U,0x1EU,0xFEU,0x20U,0x60U,0x28U,0x40U,0x69U,0xFFU,0x48U,0x40U,0x48U,0x80U,0x7EU,0xFEU,0x08U,0x06U,0x1EU,0x8CU,0xF8U,0x78U,0x08U,0x30U,0x08U,0x18U,0x08U,0x08U}}, /* 转 */
    {0x9009U,{0x00U,0x00U,0x03U,0x20U,0x22U,0x20U,0x37U,0xFEU,0x14U,0x20U,0x00U,0x20U,0xEFU,0xFFU,0x21U,0x90U,0x21U,0x92U,0x21U,0x12U,0x23U,0x12U,0x24U,0x1EU,0x58U,0x00U,0x07U,0xFEU,0x00U,0x00U,0x00U,0x00U}}, /* 选 */
    {0x62E9U,{0x30U,0x00U,0x33U,0xFEU,0x31U,0x04U,0xFCU,0x8CU,0x30U,0x70U,0x31U,0xF8U,0x33U,0x06U,0x38U,0x20U,0x73U,0xFEU,0xF0U,0x20U,0x30U,0x20U,0x37U,0xFFU,0x30U,0x20U,0x30U,0x20U,0xE0U,0x20U,0x00U,0x00U}}, /* 择 */
    {0x6309U,{0x30U,0x20U,0x30U,0x20U,0x33U,0xFEU,0xFAU,0x02U,0x32U,0x42U,0x30U,0xC0U,0x38U,0x80U,0x77U,0xFFU,0xF1U,0x8CU,0x31U,0x08U,0x33U,0x98U,0x30U,0xF0U,0x30U,0x78U,0x23U,0x8EU,0xE6U,0x02U,0x00U,0x00U}}, /* 按 */
    {0x4E0BU,{0x00U,0x00U,0xFFU,0xFFU,0x03U,0x00U,0x01U,0x00U,0x01U,0x00U,0x01U,0xC0U,0x01U,0x60U,0x01U,0x38U,0x01U,0x0CU,0x01U,0x04U,0x01U,0x00U,0x01U,0x00U,0x01U,0x00U,0x01U,0x00U,0x01U,0x00U,0x00U,0x00U}}, /* 下 */
    {0x786EU,{0x00U,0x00U,0x00U,0x80U,0x7CU,0xFCU,0x31U,0x08U,0x23U,0x18U,0x23U,0xFEU,0x39U,0x22U,0x69U,0x22U,0x69U,0xFEU,0xA9U,0x22U,0x29U,0x22U,0x29U,0xFEU,0x3BU,0x22U,0x22U,0x22U,0x00U,0x2EU,0x00U,0x00U}}, /* 确 */
    {0x8BA4U,{0x20U,0x60U,0x30U,0x60U,0x18U,0x60U,0x08U,0x60U,0x00U,0x60U,0xF0U,0x60U,0x30U,0x60U,0x30U,0x60U,0x30U,0x50U,0x30U,0xD0U,0x34U,0x98U,0x39U,0x88U,0x33U,0x0CU,0x26U,0x06U,0x04U,0x02U,0x00U,0x00U}}, /* 认 */
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
};

const uint8_t *tft_chinese_font_find(uint16_t codepoint) {
    for (size_t i = 0U; i < sizeof(g_chinese_glyphs) /
                                  sizeof(g_chinese_glyphs[0]); i++) {
        if (g_chinese_glyphs[i].codepoint == codepoint) {
            return g_chinese_glyphs[i].rows;
        }
    }
    return NULL;
}
