finnyoun9/bluepill-ota-bootloader/(commit log)

2026-08-06 Initial commit: STM32 Blue Pill OTA Bootloader System
    - Custom bootloader (8KB) with OTA state machine
    - FreeRTOS application with 5-task architecture
    - Shared UART protocol (framed, CRC-32)
    - ESP32 communication bridge (BT SPP + WiFi HTTP OTA)
    - PC-side OTA sender tool
    - Full architecture documentation
2026-08-07 docs: add complete project framework with sensor architecture
    - Rewrite README with expanded smart environment monitoring scope
    - Add docs/project-framework.md: full breadboard wiring diagram,
    pin allocation table, I2C dual-bus layout, power distribution,
    FreeRTOS 8-task architecture, ESP32 gateway design, Web/MQTT/BT
    control interfaces, and implementation phases
    - Document 12-sensor + 4-actuator system covering 7 peripheral
    protocols (I2C×2, 1-Wire, Timer Encoder/Capture, PWM, ADC, EXTI)
2026-08-08 fix(protocol): correct BootConfig_t size assert and guard FLASH macros
    - BootConfig_t static assert 56 -> 48 (actual 12 x uint32 = 48B)
    - Guard FLASH_BASE/FLASH_SIZE/FLASH_PAGE_SIZE with #ifndef to avoid
    redefinition against STM32 HAL
    - Add root platformio.ini used for bootloader build verification
    - Resolve README.md merge conflict (keep verification record)
    Verified: bootloader compiles via PlatformIO ststm32, RAM 11.0% (2252B),
    Flash 8.8% (5756B), firmware.bin ~6KB (< 8KB bootloader limit).
    [protocol.h]
2026-08-08 build(app): make application buildable via PlatformIO
    Vendor FreeRTOS V10.3.1 kernel (from STM32CubeF1 middleware) into
    application/lib/FreeRTOS and add an [env:app] build target.
    Fixes required to get a green build:
    - Add SystemClock_Config (HSE 8MHz -> PLL x9 -> 72MHz); the app had
    no clock config so 460800 UART and FreeRTOS timing were not valid
    - Add vApplicationGetIdleTaskMemory / vApplicationGetTimerTaskMemory
    (required by configSUPPORT_STATIC_ALLOCATION=1)
    - Add SVC_Handler/PendSV_Handler thin wrappers over the FreeRTOS port
    handlers (vPortSVCHandler/xPortPendSVHandler) for the vector table
    - Bump configTOTAL_HEAP_SIZE 8KB -> 12KB (5 dynamic tasks need ~11KB;
    8KB would hit th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
    [main.c, ota_config.c]
2026-08-08 fix(bridge): make ESP32 bridge actually usable end-to-end
    - Add partitions.csv with a "storage" SPIFFS partition. spiffs_init()
    previously called ESP_ERROR_CHECK on a partition that did not exist,
    which would abort/reboot the ESP32 on every start.
    - WiFi credentials: replace hardcoded YOUR_SSID/YOUR_PASSWORD with a
    runtime "WIFI <ssid>,<pass>" BT command (stored in NVS) plus a
    compile-time -D WIFI_SSID/-D WIFI_PASSWORD fallback.
    - Fix BT firmware push path: the SPP queue now carries an explicit
    length (binary images contain NUL bytes; strlen() truncated every
    chunk containing one). Add "FW <version>,<crc32-hex>" + "SEND"
    commands so Bluetooth-pushed firmware carries valid versi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
    [partitions.csv]
2026-08-08 8/8 调试
2026-08-08 fix(esp32): make the bridge build green (IDF 6 API + 2MB flash)
    All three firmware targets now compile.
    ESP-IDF 6 API migration in main.cpp:
    - esp_spp_init(ESP_SPP_MODE_CB) -> esp_spp_enhanced_init(&cfg),
    cfg.mode = ESP_SPP_MODE_CB (esp_spp_cfg_t)
    - esp_bt_dev_set_device_name() -> esp_bt_gap_set_device_name()
    - esp_wifi_is_connected() -> esp_wifi_sta_get_ap_info() == ESP_OK
    - struct inits rewritten to {} to satisfy -Werror=missing-field-initializers
    Build config for the 2MB-flash ESP32 unit:
    - sdkconfig.defaults: enable BT/Bluedroid/Classic/SPP + BTDM controller,
    CONFIG_ESPTOOLPY_FLASHSIZE_2MB
    - partitions.csv: 2MB layout; factory 1.75MB (Bluedroid image is ~1.5MB),
    storage SPIFFS 19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
    [partitions.csv]
2026-08-08 docs: record 2026-08-08 three-target build verification
    - README: fix BT service name (STM32-OTA-Bridge, not STM32-EnvMon),
    replace the command table with the actually-implemented commands
    (OTA/FW/SEND/WIFI/VERSION/STATUS/RESET), switch quickstart to the
    PlatformIO build flow, add 2026-08-08 verification record
    - docs/build-notes.md (new): ESP-IDF 6 API migration, 2MB flash layout
    and why factory must be 1.75MB, sdkconfig.defaults vs -D flags,
    protocol.cpp mirror + C/C++ flag-conflict rationale, FreeRTOS build
    gotchas (static-allocation hooks, SVC/PendSV wrappers, heap 12KB,
    linker heap reservation), domestic-proxy note for PlatformIO
2026-08-08 feat: validate Bluetooth-to-STM32 bridge bring-up
2026-08-09 fix(ota): harden Bluetooth staging and CRC validation
    [bridge_ota.py, main.cpp, protocol.cpp, protocol_smoke_test.c]
2026-08-09 feat(web): add phone-driven STM32 OTA
2026-08-09 fix: add IWDG watchdog, raise UART to 115200 baud
    [main.c, main.cpp, ota_sender.py, protocol.h]
2026-08-11 feat(app,esp32): add two-channel relay control with auto humidifier
    Relay 1 drives the humidifier, relay 2 the lights (PB12/PB13, active-low).
    Bluetooth commands RELAY1/RELAY2 ON|OFF, RELAY, AUTO ON|OFF, MANUAL are
    forwarded from the ESP32 to the STM32 via CMD_APP_MSG; the STM32 replies
    with CMD_STATUS_RSP {relay1, relay2, auto}. AUTO mode closes the loop:
    humidity below 40% turns the humidifier on, 45% or above turns it off
    (hysteresis), using the existing AHT20 fixed-point reading.
    [main.c, main.cpp, relay.c, relay.h]
2026-08-11 docs: mark relay control as code-only, pending hardware verification
    Record v0.13 (two-channel relay control) in the changelog and update the
    README status line. The ESP32 target compiles locally; the STM32 build
    and hardware relay action are still to be verified on the Windows side.
2026-08-11 feat: complete local sensing and actuator integration
2026-08-11 docs: fix relay channel mapping (relay1=light strip, relay2=humidifier)
2026-08-11 feat(web): add Web control for relays, buzzer and auto mode
    Add POST /api/control which forwards relay/buzzer/auto commands to the
    STM32 over the same CMD_APP_MSG path used by Bluetooth. The handler reads
    the full JSON body (loop over content_len to survive TCP fragmentation)
    and skips quote characters after the field name. The embedded dashboard
    control page now enables the four switches and syncs their state with
    GET /api/sensors; hardware-verified: relay1/relay2/auto toggles are
    reflected in the sensor snapshot.
    [main.cpp]
2026-08-13 feat(ui): add bilingual controls and project handoff
    [partitions.csv]
2026-08-21 fix(tools): make stlink_upload.py cross-platform (macOS/Linux)
    The upload script hardcoded openocd.exe, so flashing failed on macOS
    even after compiling successfully. Pick the binary name by sys.platform
    instead; behavior on Windows is unchanged.
    [stlink_upload.py]
2026-08-21 feat(esp32): add MQTT client on public EMQX sandbox broker
    Publishes the same sensor JSON as GET /api/sensors and accepts the same
    control fields as POST /api/control, on topics namespaced by the last 3
    MAC bytes so this device doesn't collide with others on the shared
    broker.emqx.io broker. Migrating to a private broker later is just a
    URI change.
    Extracted format_sensor_json()/build_control_message()/
    send_control_message() so HTTP and MQTT share one JSON schema and one
    STM32 command mapping instead of duplicating logic. Control parsing
    moved from a hand-rolled strstr scan to cJSON, removing the
    if/else-ordering dependency the scan needed to avoid "light" matching
    inside "light_auto".
    Bo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
    [main.cpp]
2026-08-21 fix(ci): load OpenOCD only for upload
    [stlink_upload.py]
2026-08-21 fix(stlink): extend watchdog before application flash
    [stlink_upload.py]
