finnyoun9/bluepill-ota-bootloader/docs/photos/breadboard-overview-2026-08-17.jpg

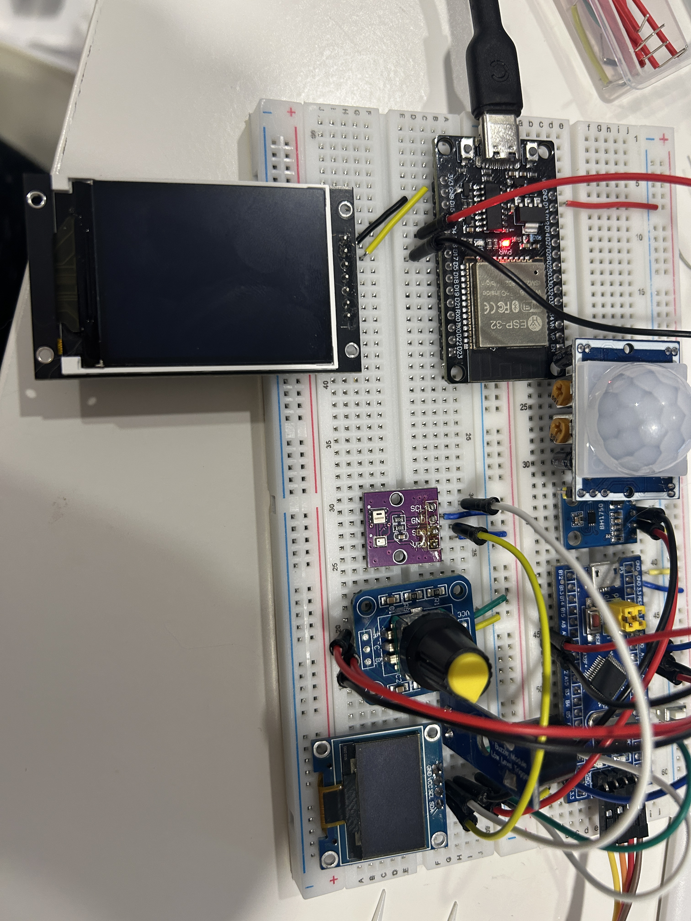
docs/photos/breadboard-overview-2026-08-17.jpg
