finnyoun9/bluepill-ota-bootloader/docs/photos/oled-utf8-fix-tft-vs-ssd1306-2026-08-17.jpg

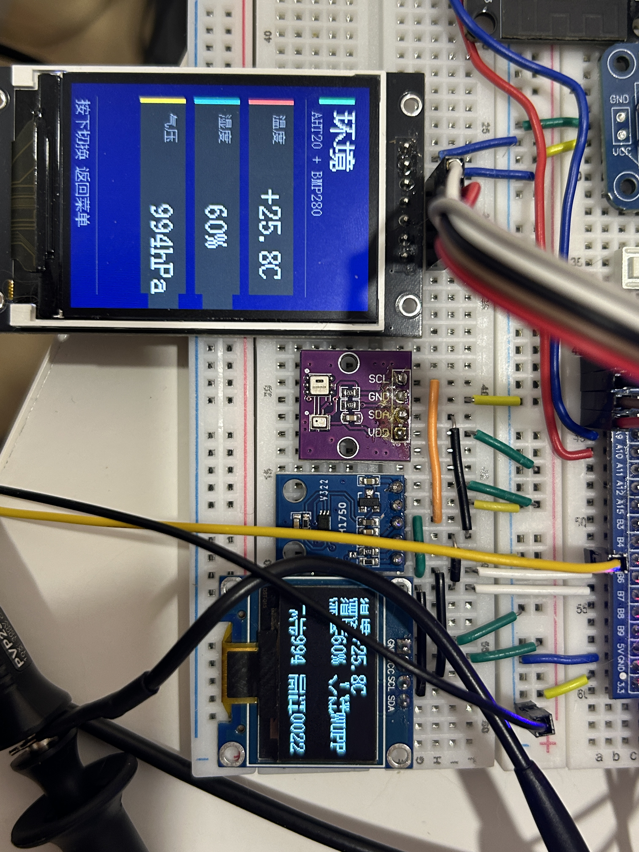
docs/photos/oled-utf8-fix-tft-vs-ssd1306-2026-08-17.jpg
